jorgeblnz/DrumIlluminator/README.md

# DrumIlluminator
Arduino UNO sketch which illuminates the drums of a drum set. 

Programa para Arduino UNO que ilumina los tambores de una batería.
