jorgeblnz/DrumIlluminator/(list of files, drawings)

Other design files:
DrumIlluminator.fzz
DrumIlluminator_With_LCD.fzz
